jnovonj/ESP32-S3-Pi-Zero-2W/3D models/ESP32-S3-WROOM-1_20211021.STEP

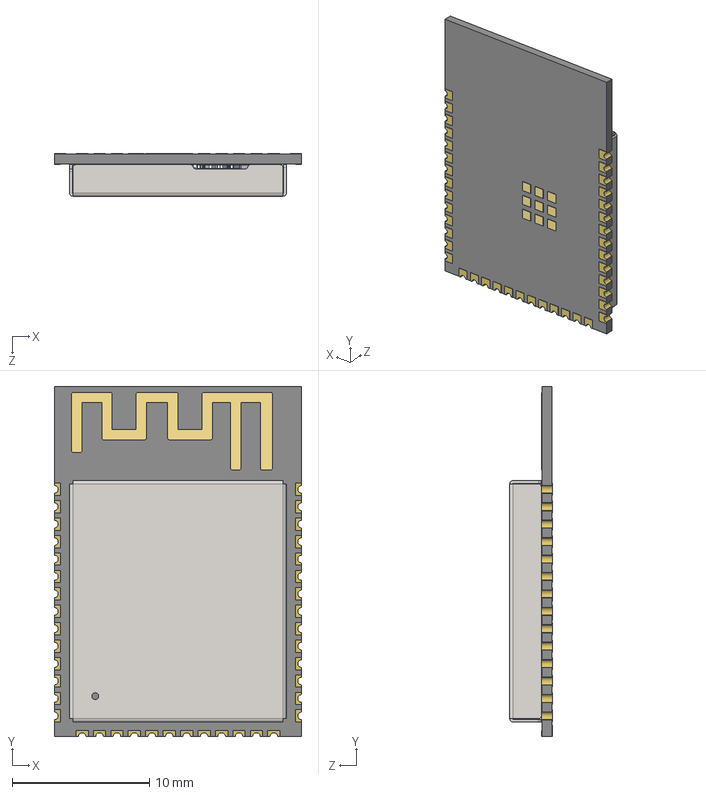
[picture p2: CAD file, 2026-11-13]
3D models/ESP32-S3-WROOM-1_20211021.STEP
18.0 x 25.5 x 3.10 mm
C0201_20210301.STEP^C0201_20210301.STEP_Submodel-C0201_part_DesignRootModel_PCB_ESP32-S3-WROOM-1_V1(2)_PCB_ESP32-S3-WROOM-1_V1 x 14
L0201_20210301.STEP^L0201_20210301.STEP_Submodel-L0201_part_DesignRootModel_PCB_ESP32-S3-WROOM-1_V1(2)_PCB_ESP32-S3-WROOM-1_V1 x 3
C0402_20210301.STEP^C0402_20210301.STEP_Submodel-C0402_part_DesignRootModel_PCB_ESP32-S3-WROOM-1_V1(2)_PCB_ESP32-S3-WROOM-1_V1
R0201_20210301.STEP^R0201_20210301.STEP_Submodel-R0201_part_DesignRootModel_PCB_ESP32-S3-WROOM-1_V1(2)_PCB_ESP32-S3-WROOM-1_V1 x 8
trace_1^Submodel-MINI-ANT-TYPEB_668419613_part_DesignRootModel_PCB_ESP32-S3-WROOM-1_V1(2)_PCB_ESP32-S3-WROOM-1_V1
DFN1006.STEP^DFN1006.STEP_Submodel-SOD882_part_DesignRootModel_PCB_ESP32-S3-WROOM-1_V1(2)_PCB_ESP32-S3-WROOM-1_V1
SOP8_rev1_20210308.STEP^SOP8_rev1_20210308.STEP_Submodel-SOP8_1P27_6P6_part_DesignRootModel_PCB_ESP32-S3-WROOM-1_V1(2)_PCB_ESP32-S3-WROOM-1_V1
XTAL3225_20210301.STEP^XTAL3225_20210301.STEP_Submodel-XTAL3225_part_DesignRootModel_PCB_ESP32-S3-WROOM-1_V1(2)_PCB_ESP32-S3-WROOM-1_V1
ESP32-S3_20210301.STEP^ESP32-S3_20210301.STEP_Submodel-QFN56_0P4_7_part_DesignRootModel_PCB_ESP32-S3-WROOM-1_V1(2)_PCB_ESP32-S3-WROOM-1_V1
uid__4-128^DesignRootModel_PCB_ESP32-S3-WROOM-1_V1(2)_PCB_ESP32-S3-WROOM-1_V1
uid__4-129^DesignRootModel_PCB_ESP32-S3-WROOM-1_V1(2)_PCB_ESP32-S3-WROOM-1_V1
uid__4-130^DesignRootModel_PCB_ESP32-S3-WROOM-1_V1(2)_PCB_ESP32-S3-WROOM-1_V1
uid__4-149^DesignRootModel_PCB_ESP32-S3-WROOM-1_V1(2)_PCB_ESP32-S3-WROOM-1_V1
uid__4-150^DesignRootModel_PCB_ESP32-S3-WROOM-1_V1(2)_PCB_ESP32-S3-WROOM-1_V1
uid__4-151^DesignRootModel_PCB_ESP32-S3-WROOM-1_V1(2)_PCB_ESP32-S3-WROOM-1_V1
uid__4-167^DesignRootModel_PCB_ESP32-S3-WROOM-1_V1(2)_PCB_ESP32-S3-WROOM-1_V1
uid__4-168^DesignRootModel_PCB_ESP32-S3-WROOM-1_V1(2)_PCB_ESP32-S3-WROOM-1_V1
uid__4-169^DesignRootModel_PCB_ESP32-S3-WROOM-1_V1(2)_PCB_ESP32-S3-WROOM-1_V1
uid__1-279^DesignRootModel_PCB_ESP32-S3-WROOM-1_V1(2)_PCB_ESP32-S3-WROOM-1_V1
uid__1-280^DesignRootModel_PCB_ESP32-S3-WROOM-1_V1(2)_PCB_ESP32-S3-WROOM-1_V1
uid__1-292^DesignRootModel_PCB_ESP32-S3-WROOM-1_V1(2)_PCB_ESP32-S3-WROOM-1_V1
uid__1-298^DesignRootModel_PCB_ESP32-S3-WROOM-1_V1(2)_PCB_ESP32-S3-WROOM-1_V1
uid__1-299^DesignRootModel_PCB_ESP32-S3-WROOM-1_V1(2)_PCB_ESP32-S3-WROOM-1_V1
uid__1-300^DesignRootModel_PCB_ESP32-S3-WROOM-1_V1(2)_PCB_ESP32-S3-WROOM-1_V1
uid__1-301^DesignRootModel_PCB_ESP32-S3-WROOM-1_V1(2)_PCB_ESP32-S3-WROOM-1_V1
uid__1-304^DesignRootModel_PCB_ESP32-S3-WROOM-1_V1(2)_PCB_ESP32-S3-WROOM-1_V1
uid__1-305^DesignRootModel_PCB_ESP32-S3-WROOM-1_V1(2)_PCB_ESP32-S3-WROOM-1_V1
uid__1-308^DesignRootModel_PCB_ESP32-S3-WROOM-1_V1(2)_PCB_ESP32-S3-WROOM-1_V1
uid__1-310^DesignRootModel_PCB_ESP32-S3-WROOM-1_V1(2)_PCB_ESP32-S3-WROOM-1_V1
uid__1-311^DesignRootModel_PCB_ESP32-S3-WROOM-1_V1(2)_PCB_ESP32-S3-WROOM-1_V1
uid__1-325^DesignRootModel_PCB_ESP32-S3-WROOM-1_V1(2)_PCB_ESP32-S3-WROOM-1_V1
uid__1-334^DesignRootModel_PCB_ESP32-S3-WROOM-1_V1(2)_PCB_ESP32-S3-WROOM-1_V1
uid__1-338^DesignRootModel_PCB_ESP32-S3-WROOM-1_V1(2)_PCB_ESP32-S3-WROOM-1_V1
uid__1-339^DesignRootModel_PCB_ESP32-S3-WROOM-1_V1(2)_PCB_ESP32-S3-WROOM-1_V1
uid__1-340^DesignRootModel_PCB_ESP32-S3-WROOM-1_V1(2)_PCB_ESP32-S3-WROOM-1_V1
uid__1-343^DesignRootModel_PCB_ESP32-S3-WROOM-1_V1(2)_PCB_ESP32-S3-WROOM-1_V1
uid__1-344^DesignRootModel_PCB_ESP32-S3-WROOM-1_V1(2)_PCB_ESP32-S3-WROOM-1_V1
uid__1-345^DesignRootModel_PCB_ESP32-S3-WROOM-1_V1(2)_PCB_ESP32-S3-WROOM-1_V1
uid__1-352^DesignRootModel_PCB_ESP32-S3-WROOM-1_V1(2)_PCB_ESP32-S3-WROOM-1_V1
uid__1-354^DesignRootModel_PCB_ESP32-S3-WROOM-1_V1(2)_PCB_ESP32-S3-WROOM-1_V1
uid__1-355^DesignRootModel_PCB_ESP32-S3-WROOM-1_V1(2)_PCB_ESP32-S3-WROOM-1_V1
uid__1-357^DesignRootModel_PCB_ESP32-S3-WROOM-1_V1(2)_PCB_ESP32-S3-WROOM-1_V1
uid__1-358^DesignRootModel_PCB_ESP32-S3-WROOM-1_V1(2)_PCB_ESP32-S3-WROOM-1_V1
uid__1-359^DesignRootModel_PCB_ESP32-S3-WROOM-1_V1(2)_PCB_ESP32-S3-WROOM-1_V1
uid__1-364^DesignRootModel_PCB_ESP32-S3-WROOM-1_V1(2)_PCB_ESP32-S3-WROOM-1_V1
uid__1-365^DesignRootModel_PCB_ESP32-S3-WROOM-1_V1(2)_PCB_ESP32-S3-WROOM-1_V1
uid__1-371^DesignRootModel_PCB_ESP32-S3-WROOM-1_V1(2)_PCB_ESP32-S3-WROOM-1_V1
uid__1-375^DesignRootModel_PCB_ESP32-S3-WROOM-1_V1(2)_PCB_ESP32-S3-WROOM-1_V1
uid__1-376^DesignRootModel_PCB_ESP32-S3-WROOM-1_V1(2)_PCB_ESP32-S3-WROOM-1_V1
uid__1-378^DesignRootModel_PCB_ESP32-S3-WROOM-1_V1(2)_PCB_ESP32-S3-WROOM-1_V1
uid__1-379^DesignRootModel_PCB_ESP32-S3-WROOM-1_V1(2)_PCB_ESP32-S3-WROOM-1_V1
uid__1-380^DesignRootModel_PCB_ESP32-S3-WROOM-1_V1(2)_PCB_ESP32-S3-WROOM-1_V1
uid__1-381^DesignRootModel_PCB_ESP32-S3-WROOM-1_V1(2)_PCB_ESP32-S3-WROOM-1_V1
uid__1-382^DesignRootModel_PCB_ESP32-S3-WROOM-1_V1(2)_PCB_ESP32-S3-WROOM-1_V1
uid__1-383^DesignRootModel_PCB_ESP32-S3-WROOM-1_V1(2)_PCB_ESP32-S3-WROOM-1_V1
uid__1-384^DesignRootModel_PCB_ESP32-S3-WROOM-1_V1(2)_PCB_ESP32-S3-WROOM-1_V1
uid__1-385^DesignRootModel_PCB_ESP32-S3-WROOM-1_V1(2)_PCB_ESP32-S3-WROOM-1_V1
uid__1-386^DesignRootModel_PCB_ESP32-S3-WROOM-1_V1(2)_PCB_ESP32-S3-WROOM-1_V1
uid__1-387^DesignRootModel_PCB_ESP32-S3-WROOM-1_V1(2)_PCB_ESP32-S3-WROOM-1_V1
uid__1-388^DesignRootModel_PCB_ESP32-S3-WROOM-1_V1(2)_PCB_ESP32-S3-WROOM-1_V1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
