jnovonj/ESP32-S3-Pi-Zero-2W/ESP32 S3 Pi Zero 2 W.kicad_pcb

## KiCad design ESP32 S3 Pi Zero 2 W.kicad_pcb (2026-11-13)

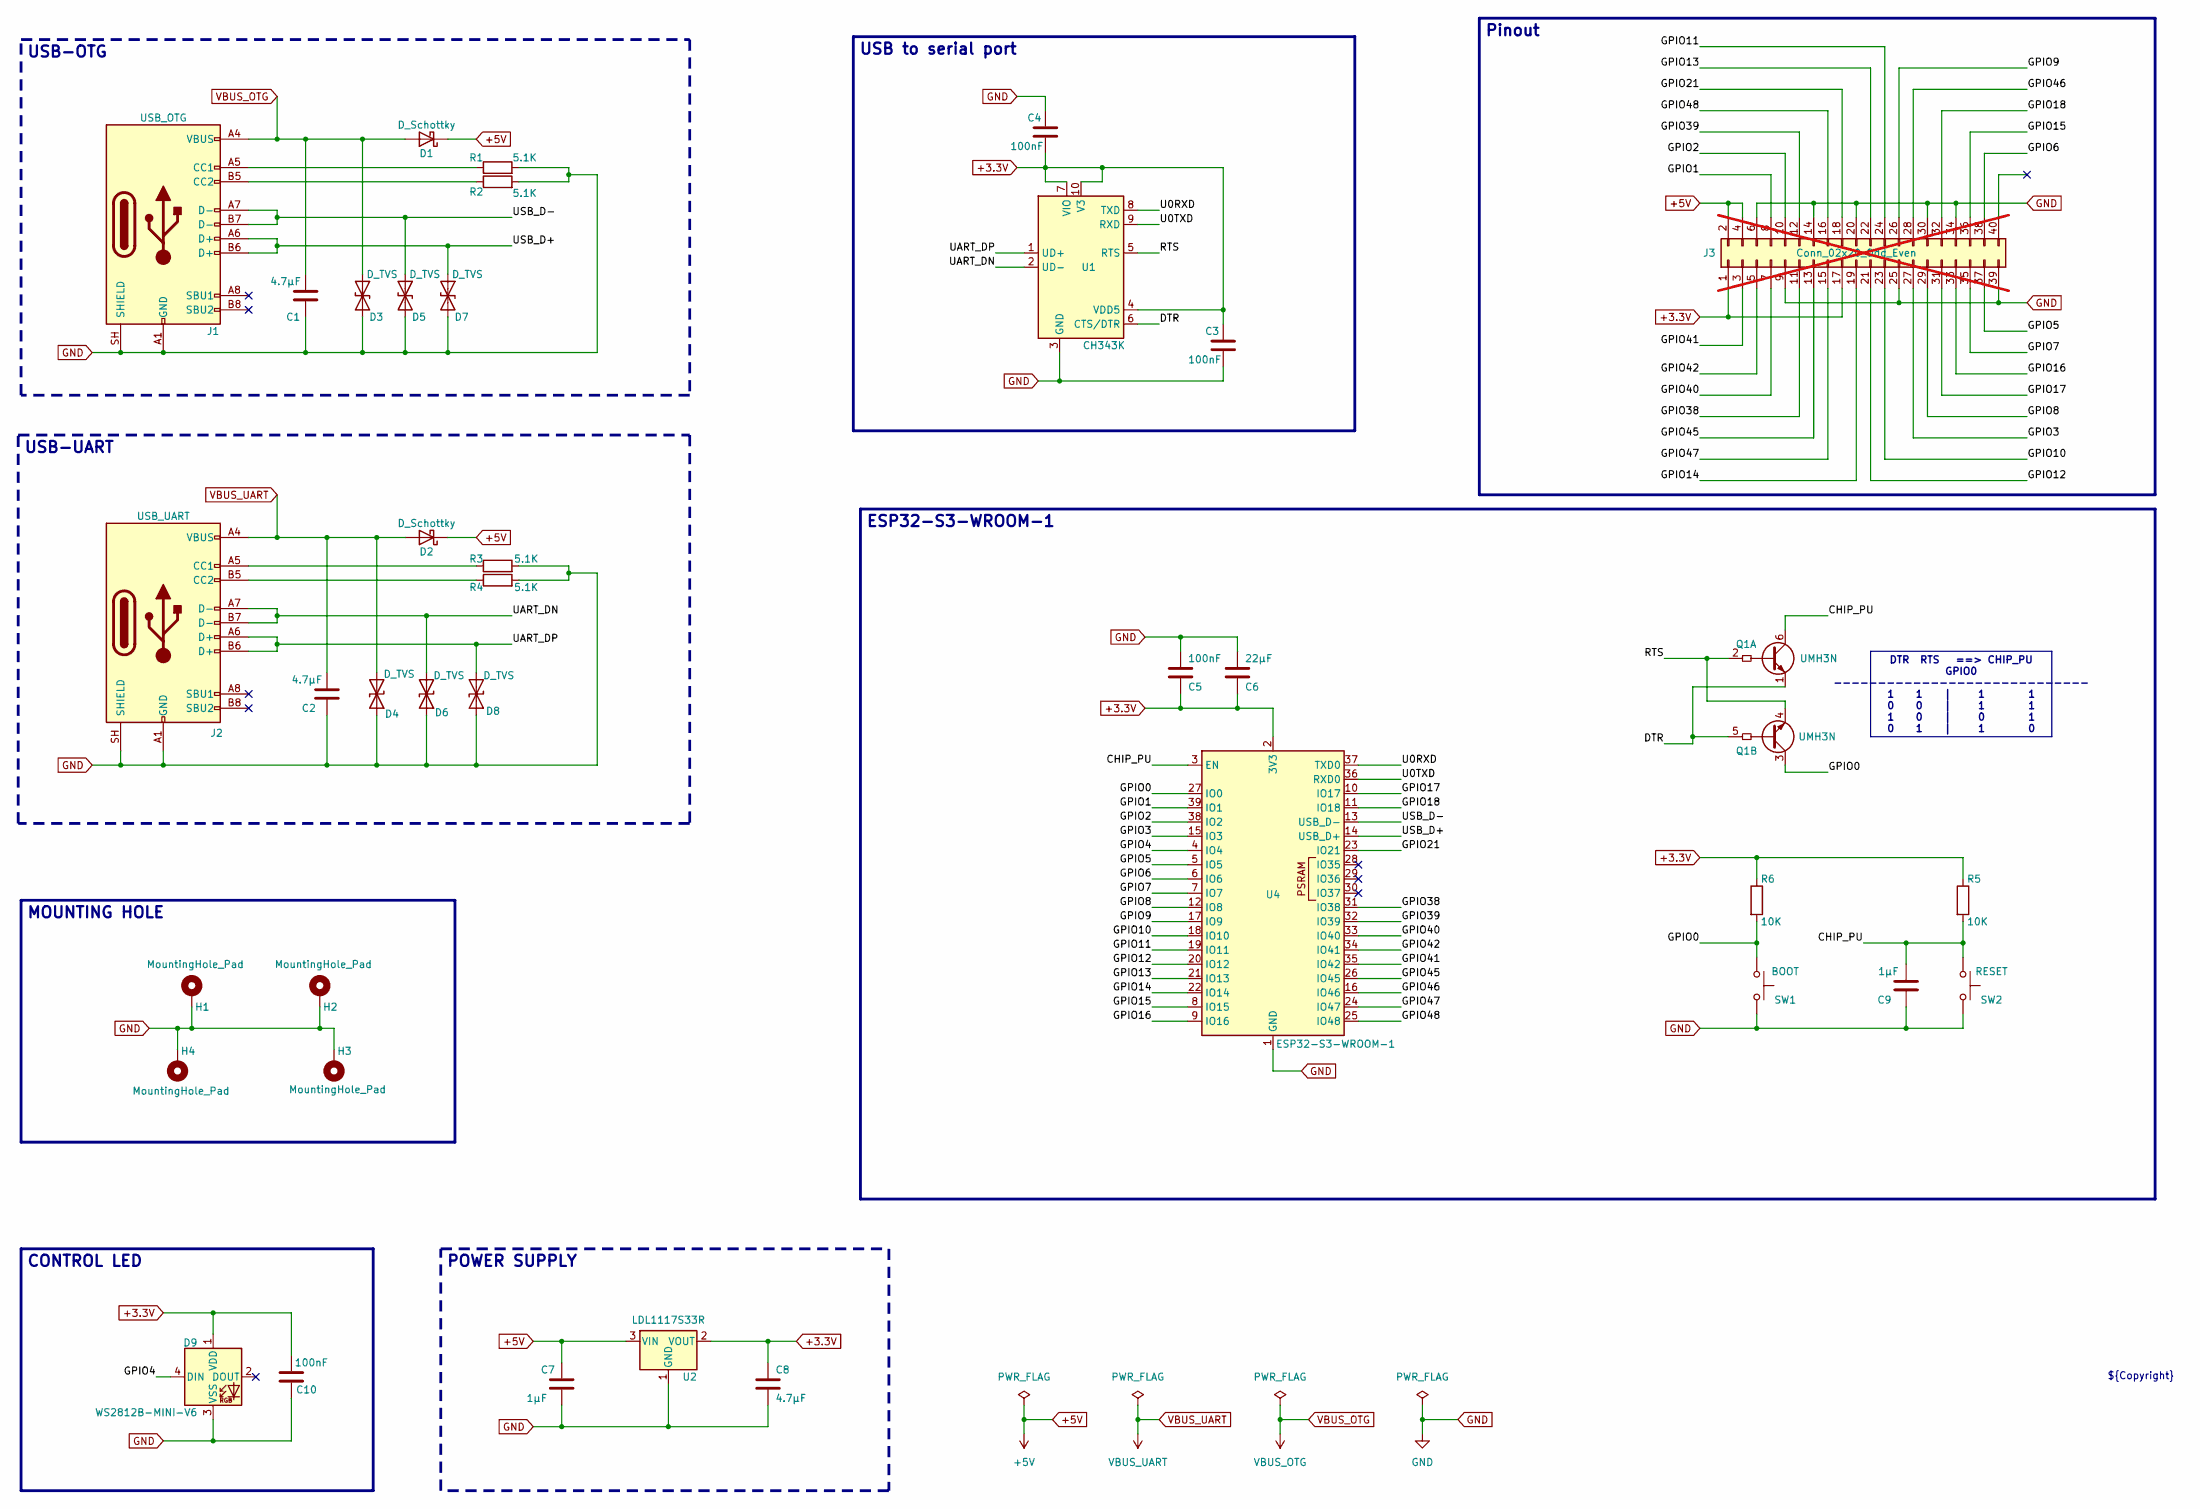
[picture p3: schematic ESP32 S3 Pi Zero 2 W.kicad_sch, ${Title}]

Parts:
C1, C2: 4.7µF; C_0603_1608Metric_Pad1.08x0.95mm_HandSolder; MFR.Part # HQ CA0149362
C3, C4, C10: 100nF; C_0603_1608Metric_Pad1.08x0.95mm_HandSolder; MFR.Part # HQ CA0001420
C5: 100nF; C_0603_1608Metric_Pad1.08x0.95mm_HandSolder; Mfr. Part # GRM188R71H104JA93D
C6: 22μF; C_0603_1608Metric_Pad1.08x0.95mm_HandSolder; Mfr. Part # CL10A226MP8NUNE
C7: 1μF; C_0603_1608Metric_Pad1.08x0.95mm_HandSolder; MFR.Part # HQ CA0137201
C8: 4.7µF; C_0603_1608Metric_Pad1.08x0.95mm_HandSolder; MFR.Part # HQ CA0001420
C9: 1µF; C_0603_1608Metric_Pad1.08x0.95mm_HandSolder; MFR.Part # HQ CA0137201
D1, D2: D_Schottky; D_SOD-323_HandSoldering; MFR.Part # HQ DS0183206
D3, D4, D5, D6, D7, D8: D_TVS; D_SOD-323_HandSoldering; MFR.Part # HQ UN0003855
D9: WS2812B-MINI-V6; LED_WS2812B-Mini_PLCC4_3.5x3.5mm; MFR.Part # HQ PH44591203
H1, H2, H3, H4: MountingHole_Pad; MountingHole_2.7mm_M2.5_Pad_Via
J1: USB_OTG; USB_C_Receptacle_GCT_USB4105-xx-A_16P_TopMnt_Horizontal; MFR.Part # HQ ZHLM0001696
J2: USB_UART; USB_C_Receptacle_GCT_USB4105-xx-A_16P_TopMnt_Horizontal; MFR.Part # HQ ZHLM0001696
J3: Conn_02x20_Odd_Even; PinHeader_2x20_P2.54mm_Vertical; Mfr. Part # 1; not fitted
Q1: UMH3N; SOT-363_SC-70-6; MFR.Part # HQ DS0127880
R1, R2, R3, R4: 5.1K; R_0603_1608Metric_Pad0.98x0.95mm_HandSolder; MFR.Part # HQ RE0010352
R5, R6: 10K; R_0603_1608Metric_Pad0.98x0.95mm_HandSolder; MFR.Part # HQ RE0023891
SW1: BOOT; SW_SPST_B3U-1000P; MFR.Part # HQ SW0036094
SW2: RESET; SW_SPST_B3U-1000P; MFR.Part # HQ SW0036094
U1: CH343K; SSOP-10-1EP_3.9x4.9mm_P1mm_EP2.1x3.3mm; Mfr. Part # CH343K
U2: LDL1117S33R; SOT-223-3_TabPin2; MFR.Part # HQ IC0414375
U4: ESP32-S3-WROOM-1; MFR.Part # HQ ZHLM0347370

Connections:
+3.3V: C3.1, C4.2, C5.1, C6.1, C8.1, C10.2, D9.1 (VDD), J3.1, J3.17, R5.1, R6.1, U1.4 (VDD5), U1.7 (VIO), U1.10 (V3), U2.2 (VOUT), U4.2 (3V3)
+5V: C7.1, D1.1 (K), D2.1 (K), J3.2, J3.4, U2.3 (VIN)
/CHIP_PU: C9.1, Q1.6 (C1), R5.2, SW2.1, U4.3 (EN)
/DTR: Q1.1 (E1), Q1.5 (B2), U1.6 (CTS/DTR)
/GPIO0: Q1.3 (C2), R6.2, SW1.1, U4.27 (IO0)
/GPIO1: J3.8, U4.39 (IO1)
/GPIO2: J3.10, U4.38 (IO2)
/GPIO3: J3.27, U4.15 (IO3)
/GPIO4: D9.4 (DIN), U4.4 (IO4)
/GPIO5: J3.37, U4.5 (IO5)
/GPIO6: J3.38, U4.6 (IO6)
/GPIO7: J3.35, U4.7 (IO7)
/GPIO8: J3.29, U4.12 (IO8)
/GPIO9: J3.26, U4.17 (IO9)
/GPIO10: J3.23, U4.18 (IO10)
/GPIO11: J3.24, U4.19 (IO11)
/GPIO12: J3.21, U4.20 (IO12)
/GPIO13: J3.22, U4.21 (IO13)
/GPIO14: J3.19, U4.22 (IO14)
/GPIO15: J3.36, U4.8 (IO15)
/GPIO16: J3.33, U4.9 (IO16)
/GPIO17: J3.31, U4.10 (IO17)
/GPIO18: J3.32, U4.11 (IO18)
/GPIO21: J3.18, U4.23 (IO21)
/GPIO38: J3.11, U4.31 (IO38)
/GPIO39: J3.12, U4.32 (IO39)
/GPIO40: J3.7, U4.33 (IO40)
/GPIO41: J3.3, U4.35 (IO42)
/GPIO42: J3.5, U4.34 (IO41)
/GPIO45: J3.13, U4.26 (IO45)
/GPIO46: J3.28, U4.16 (IO46)
/GPIO47: J3.15, U4.24 (IO47)
/GPIO48: J3.16, U4.25 (IO48)
/RTS: Q1.2 (B1), Q1.4 (E2), U1.5 (RTS)
/U0RXD: U1.8 (TXD), U4.37 (TXD0)
/U0TXD: U1.9 (RXD), U4.36 (RXD0)
/UART_DN: D6.2 (A2), J2.A7 (D-), J2.B7 (D-), U1.2 (UD-)
/UART_DP: D8.2 (A2), J2.A6 (D+), J2.B6 (D+), U1.1 (UD+)
/USB_D+: D7.1 (A1), J1.A6 (D+), J1.B6 (D+), U4.14 (USB_D+)
/USB_D-: D5.1 (A1), J1.A7 (D-), J1.B7 (D-), U4.13 (USB_D-)
GND: C1.1, C2.1, C3.2, C4.1, C5.2, C6.2, C7.2, C8.2, C9.2, C10.1, D3.2 (A2), D4.1 (A1), D5.2 (A2), D6.1 (A1), D7.2 (A2), D8.1 (A1), D9.3 (VSS), H1.1 (1_1), H2.1 (1_1), H3.1 (1_1), H4.1 (1_1), J1.A1 (GND), J1.A12 (GND), J1.B1 (GND), J1.B12 (GND), J1.SH (SHIELD), J2.A1 (GND), J2.A12 (GND), J2.B1 (GND), J2.B12 (GND), J2.SH (SHIELD), J3.6, J3.9, J3.14, J3.20, J3.25, J3.30, J3.34, J3.39, R1.2, R2.2, R3.2, R4.2, SW1.2, SW2.2, U1.3 (GND), U1.11 (GND), U2.1 (GND), U4.1 (GND), U4.40 (GND), U4.41 (GND)
unnamed: J1.A5 (CC1), R1.1
unnamed: J1.B5 (CC2), R2.1
unnamed: J2.A5 (CC1), R3.1
unnamed: J2.B5 (CC2), R4.1
VBUS_OTG: C1.2, D1.2 (A), D3.1 (A1), J1.A4 (VBUS), J1.A9 (VBUS), J1.B4 (VBUS), J1.B9 (VBUS)
VBUS_UART: C2.2, D2.2 (A), D4.2 (A2), J2.A4 (VBUS), J2.A9 (VBUS), J2.B4 (VBUS), J2.B9 (VBUS)

Notes on the sheet:
${Copyright}
POWER SUPPLY
ESP32-S3-WROOM-1
Pinout
MOUNTING HOLE
DTR RTS ==> CHIP_PU GPIO0 ----------------------------- 1 1 | 1 1 0 0 | 1 1 1 0 | 0 1 0 1 | 1 0
USB-OTG
USB to serial port
USB-UART
CONTROL LED

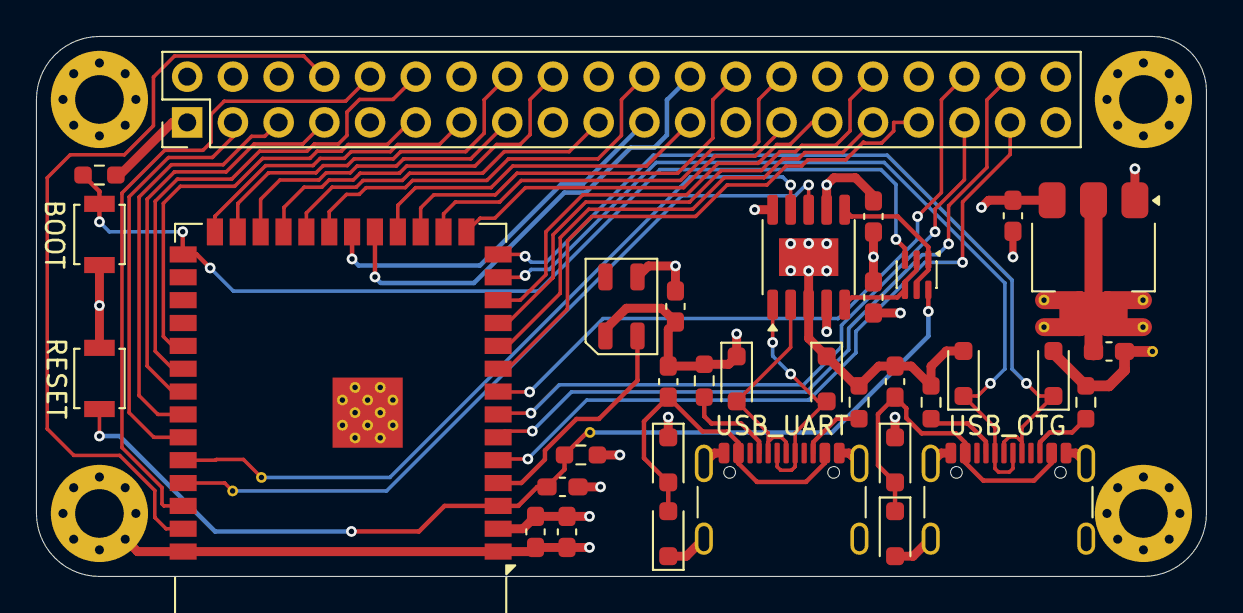
[picture p4: board ESP32 S3 Pi Zero 2 W.kicad_pcb from above]

Board: 4 copper layers, 65.0 x 30.0 mm, 38 parts (0 on the bottom side), 47 nets.
