jnovonj/ESP32-S3-Pi-Zero-2W/(commit log)

2026-11-13 First Comit ESP32-S3 Pi Zero 2 W
    [ESP32 S3 Pi Zero 2 W.kicad_pcb, ESP32 S3 Pi Zero 2 W.kicad_sch, ESP32-S3-WROOM-1_20211021.STEP]
2026-11-13 Initial commit: ESP32-S3 Pi Zero 2 W hardware design
