jnovonj/ESP32-S3-Pi-Zero-2W/(notices)

Notices in the files:
ESP32 S3 Pi Zero 2 W.kicad_pcb:
©jnovonj, 2025
parts and their libraries:
Copyright: ©jnovonj, 2026
